ultrazohm/uz_d_absolute_encoder/Project Outputs for uz_d_absolute_encoder/Rev02/BOM/BOM_JLC-uz_d_absolute_encoder_24_11_25.xlsx

Quantity | Comment | Designator | Manufacturer | Value | Description | Footprint | Voltage | Dielectric | Manufacturer Part Number | LCSC Part Number
19 | 100 nF | C7A, C7B, C7C, C8A, C8B, C8C, C9A, C9B, C9C, C14A, C14B, C14C, C15A, C15B, C15C, C16A, C16B, C16C, C17 | YAGEO | 100 nF | Capacitor 0603, 50 VDC, 100 nF, X7R | C_0603 |  |  | CC0603KRX7R9BB104 | C14663
12 | 1 nF | C10A, C10B, C10C, C11A, C11B, C11C, C12A, C12B, C12C, C13A, C13B, C13C | AVX | 1 nF | Capacitor 0603, 50 VDC, 1 nF, C0G | C_0603 |  |  | 06035A102JAT2A | C106246
1 | 150060BS75000 | D1 | Wuerth Elektronik |  | WL-SMCW SMD Mono-color Chip LED Waterclear Blue | WL-SMCW_0603 |  |  | 150060BS84000 | C5197644
1 | KT-0603R | D2 | Hubei KENTO Elec |  | LED RED 520~625NM 90~100MCD@20MA TOP VIEW 0603 ROHS | WL-SMCW_0603 |  |  | KT-0603R | C2286
1 | 19-217/GHC-YR1S2/3T | D3 | Everlight Elec |  | LED GREEN 520~535NM 112~258MCD@20MA TOP VIEW 0603 ROHS | WL-SMCW_0603 |  |  | 19-217/GHC-YR1S2/3T | C72043
6 | CDSOT23-SM712 | D4A, D4B, D4C, D5A, D5B, D5C | Bourns | 7V | TVS Diode 7V | SOT95P230X117-3N | 7V |  | CDSOT23-SM712 | C404012
3 | Littelfuse_PTC_1812 | F1, F2, F3 | Littelfuse | PTC, 1.1 A, 24V | POLYSWITCH RESETTABLE DEVICES | 1812_PTC_Polyfuse_Littelfuse | 24V |  | Littelfuse_PTC_1812 | C70119
3 | DSUB1.385-2H9 | J1A, J1B, J1C | TE Connectivity |  | Connector; D Subminiature; 9 Position; Right Angle; Pitch 1.385 mm | DSUB1.385-2H9 |  |  | DSUB1.385-2H9 | C141882
9 | BLM31PG330SN1L | L1A, L1B, L1C, L2A, L2B, L2C, L3A, L3B, L3C | Murata Electronics | 33ohms | 9mΩ ±25% 33Ω@100MHz 6A | IND 1206_3216 |  |  | BLM31PG330SN1L | C74090
27 | 0R | R2, R10A, R10B, R10C, R11A, R11B, R11C, R12A, R12B, R12C, R13A, R13B, R13C, R14A, R14B, R14C, R17A, R17B, R17C, R26A, R26B, R26C, R27A, R27B, R27C, R40, R41 | YAGEO | 0R | SMD resistor E24 series | RES 0603_1608 |  |  | RC0603JR-070RL | C21189
1 | 24k9 | R8 | Vishay | 24k9 | SMD resistor 1% | RES 0603_1608 |  |  | CRCW060324K9FKEA | C844763
12 | 10k | R15A, R15B, R15C, R16A, R16B, R16C, R23A, R23B, R23C, R24A, R24B, R24C | KOA Speer | 10k | SMD resistor E24 series | RES 0603_1608 |  |  | RK73B1JTTD103J | C25804
12 | 1k | R18A, R18B, R18C, R19A, R19B, R19C, R20A, R20B, R20C, R21A, R21B, R21C | UNI-ROYAL | 1k | SMD resistor E24 series | RES 0603_1608 |  |  | 0603WAF1001T5E | C21190
6 | 120R | R22A, R22B, R22C, R25A, R25B, R25C | KOA Speer | 120R | SMD resistor E24 series | RES 0603_1608 |  |  | RK73B1JTTD121J | C22787
4 | 4k7 | R29, R31, R32, R33 | UNI-ROYAL | 4k7 | SMD resistor E24 series | RES 0603_1608 |  |  | 0603WAF4701T5E | C23162
1 | 2k2 | R30 | KOA Speer | 2k2 | SMD resistor E24 series | RES 0603_1608 |  |  | RK73B1JTTD222J | C4190
14 | 100k | R34, R35, R42A, R42B, R42C, R43A, R43B, R43C, R44A, R44B, R44C, R45A, R45B, R45C | KOA Speer | 100k | SMD resistor E24 series | RES 0603_1608 |  |  | RK73B1JTTD104J | C25803
12 | 10R | R36A, R36B, R36C, R37A, R37B, R37C, R38A, R38B, R38C, R39A, R39B, R39C | Vishay | 10R | SMD 1/10watt 10ohms 1% | RES 0603_1608 |  |  | CRCW060310R0FKTA | C2091419
3 | SS-3235S-L1 | S1A, S1B, S1C | XKB Connection | DPDT | 50mA Horizontal attachment DPDT 12V 12V 50mA 10,000 times Black SMD Slide Switches ROHS | SS-3235S-L1 |  |  | SS-3235S-L1 | C500055
1 | M24C02-WMN6TP | U1 | STMicroelectronics | M24C02-WMN6TP | 2Kbit I2C SOP-8 EEPROM ROHS | D0008A_N |  |  | M24C02-WMN6TP | C7562
3 | TXB0108PWR | U2A, U2B, U2C | Texas Instruments | 3.6 - 5.5V | Voltage Levels 8-Bit Bi-directional V-Level Translator | SOP65P640X120-20N |  |  | TXB0108PWR | C53406
6 | THVD1450DR | U3A, U3B, U3C, U4A, U4B, U4C | Texas Instruments |  | 3.3-V to 5-V RS-485 transceiver with +/-18-kV IEC ESD protection 8-SOIC -40 to 125 | SOIC127P600X175-8N |  |  | THVD1450DR | C2671361
