ultrazohm/uz_d_absolute_encoder/Project Outputs for uz_d_absolute_encoder/Rev01/SCH_uz_d_absolute_encoder_Default_Rev01.PDF

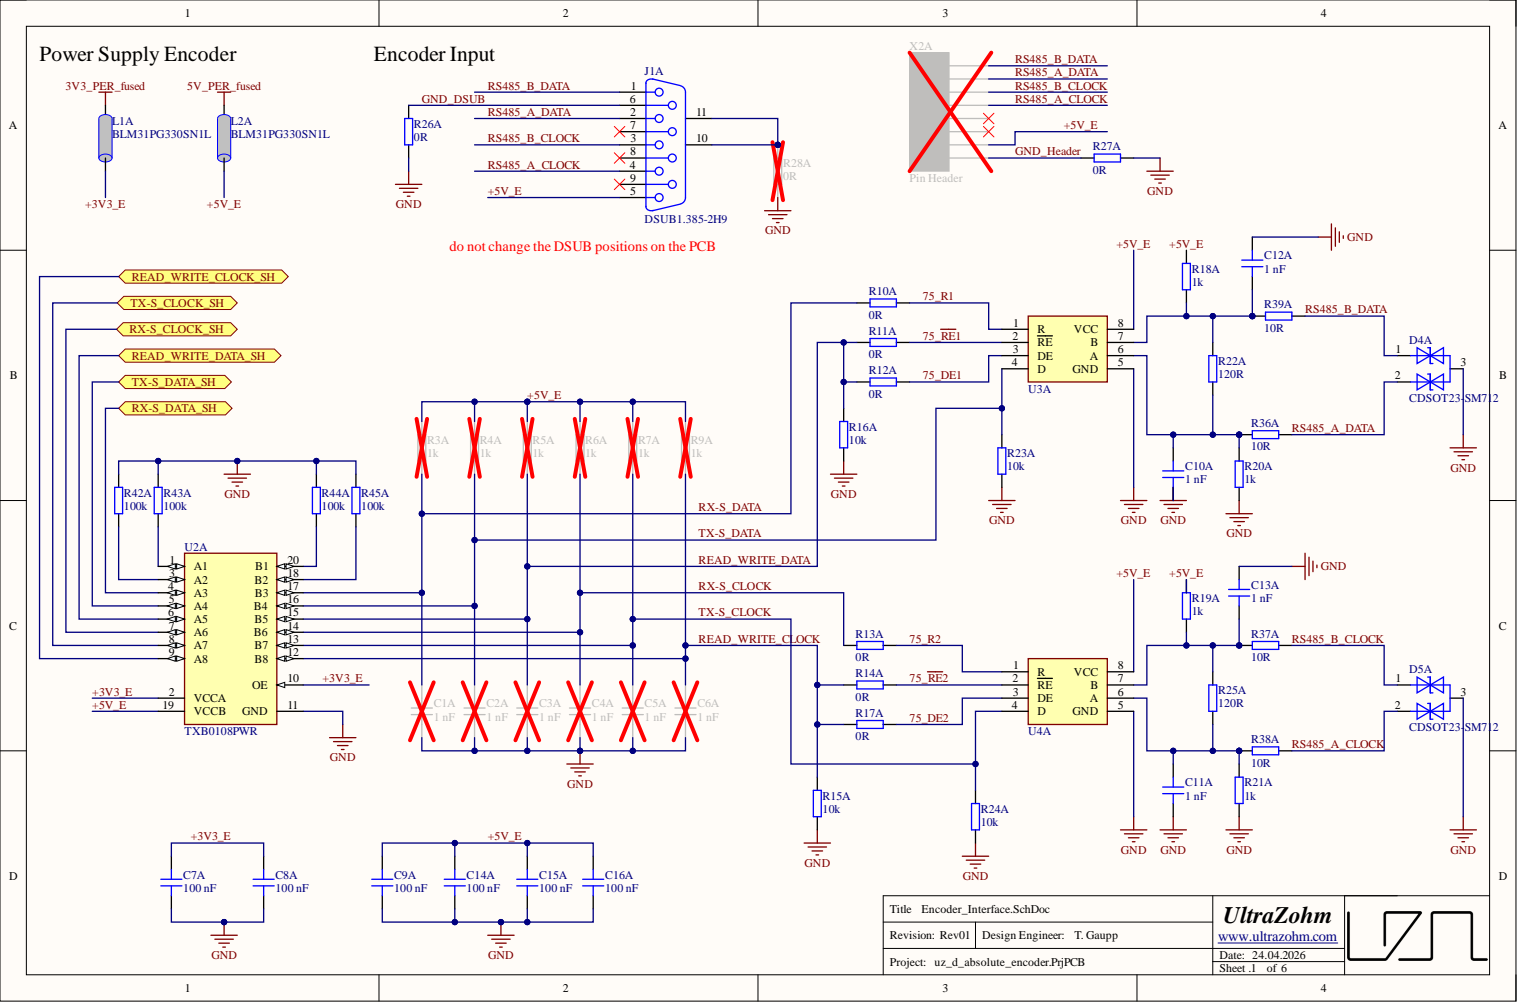
[picture p11: page 1]

do not change the DSUB positions on the PCB

DE 3
D 4

Revision:

Date: 24.04.2026

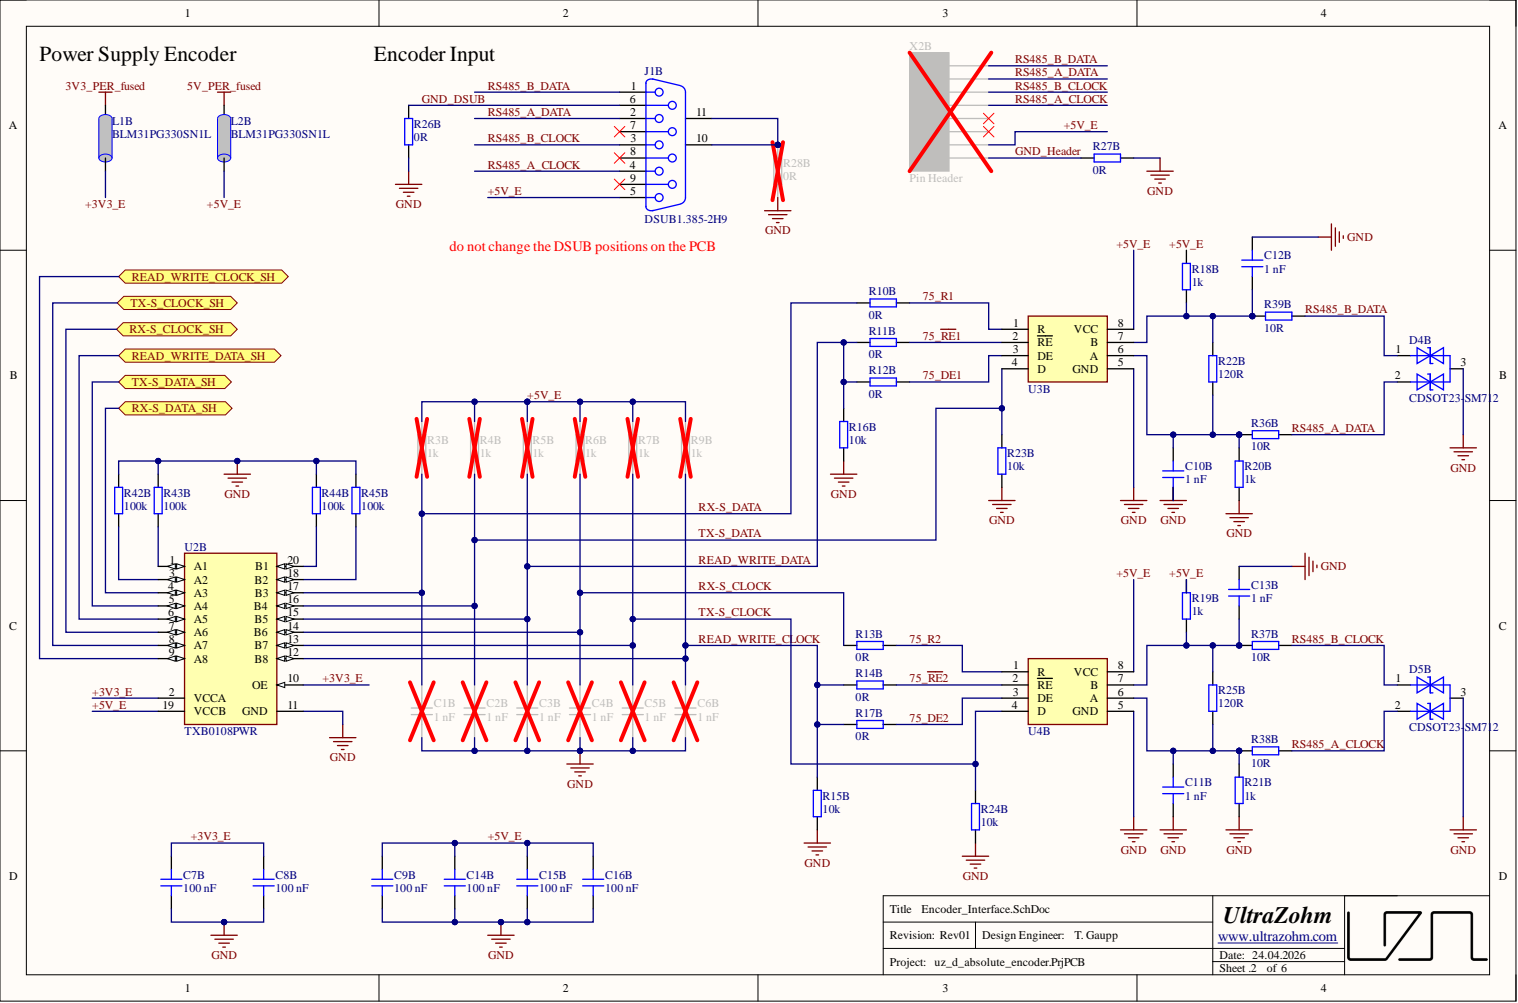
[picture p12: page 2]

do not change the DSUB positions on the PCB

DE 3
D 4

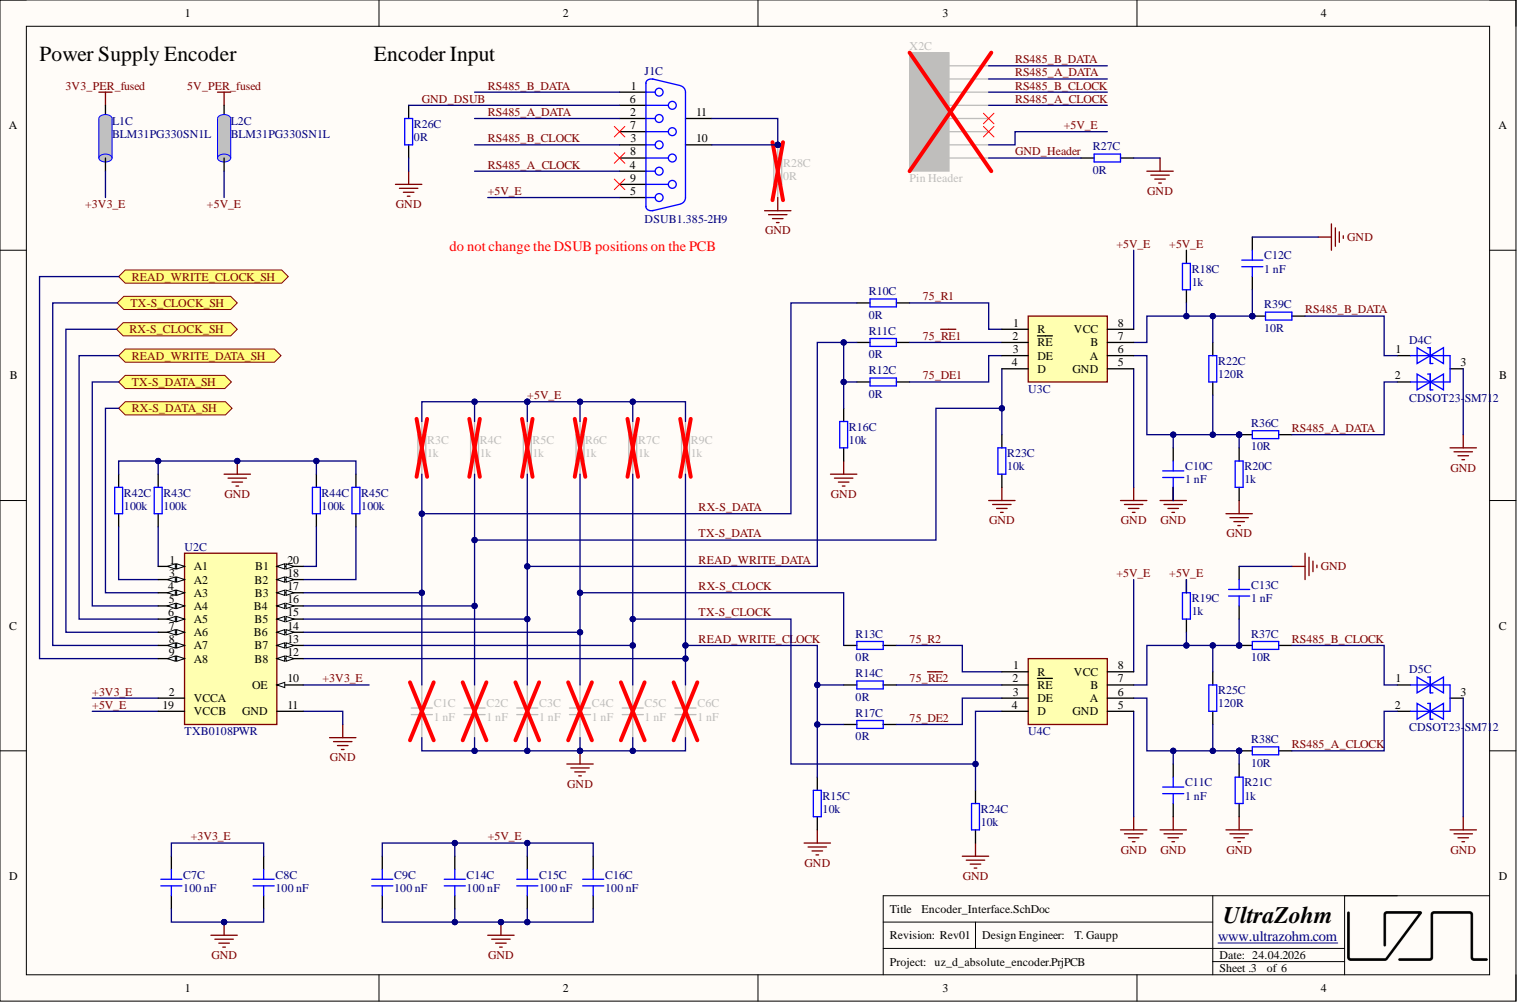
[picture p13: page 3]

do not change the DSUB positions on the PCB

DE 3
D 4

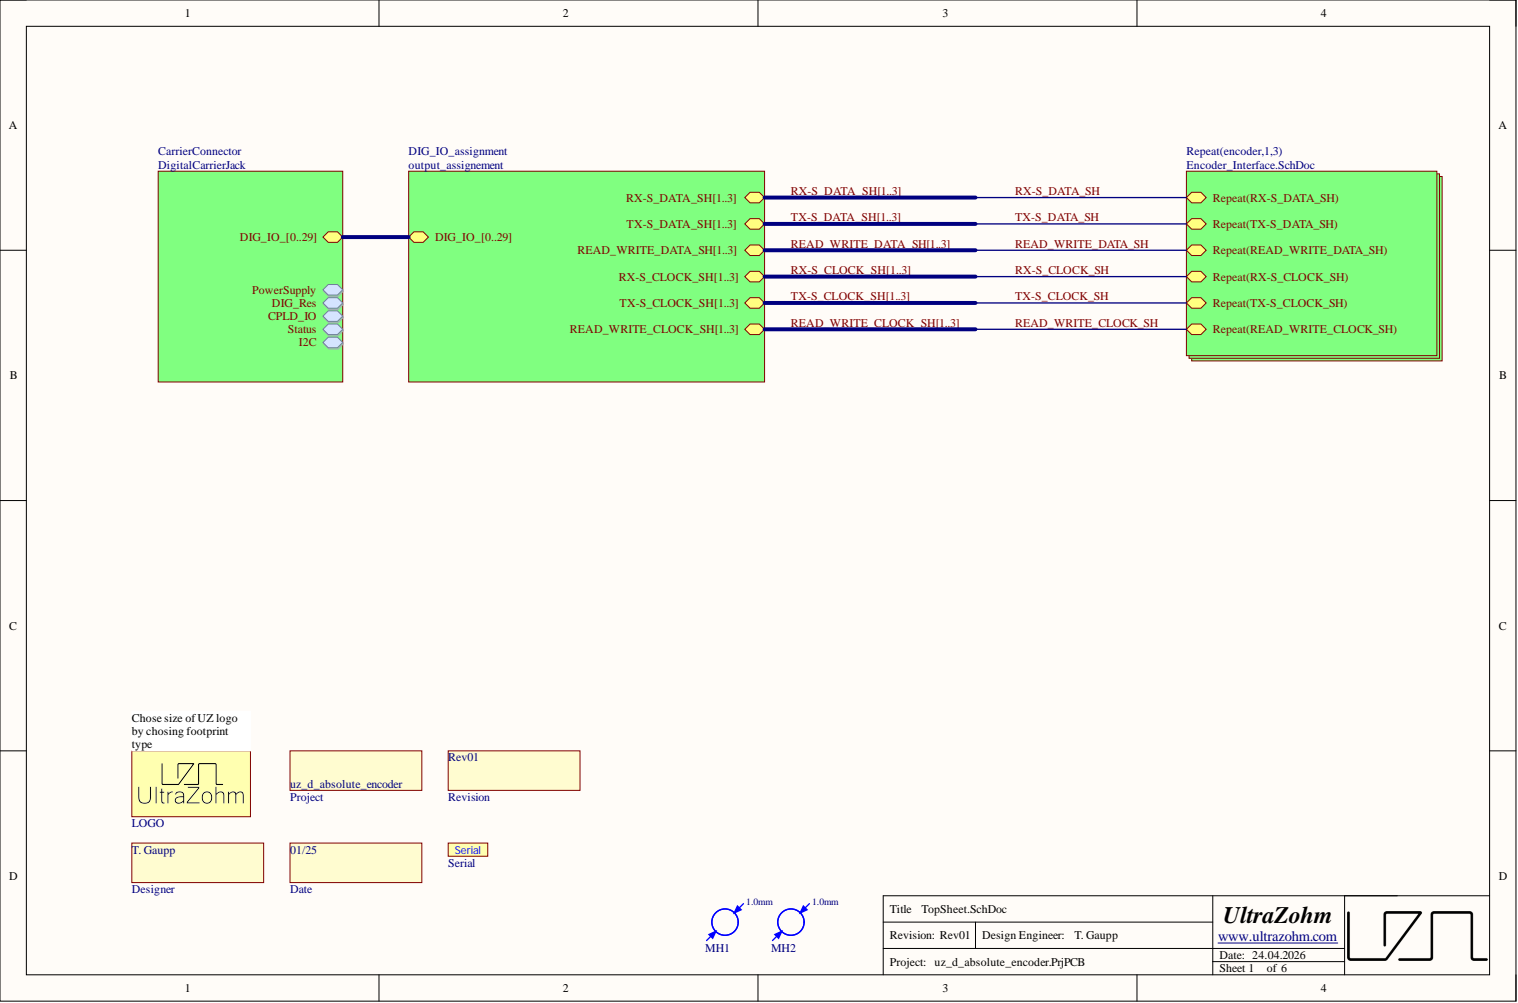
[picture p14: page 4]

Chose size of UZ logo
by chosing footprint
type

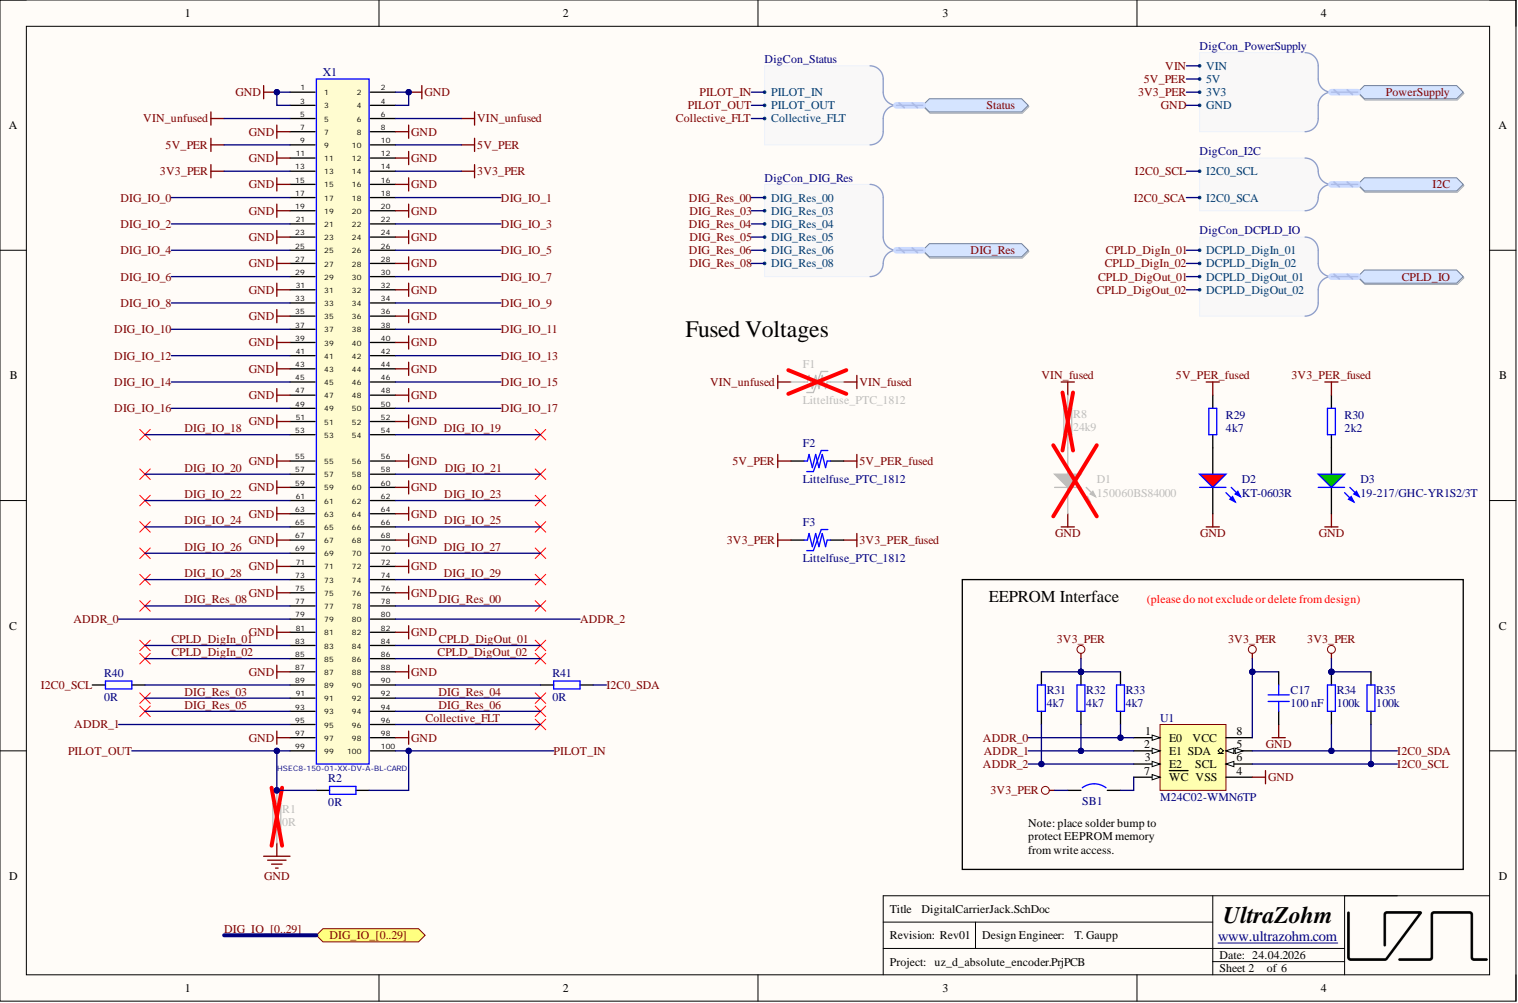
[picture p15: page 5]

HSEC8-150-01-XX-DV-A-BL-CARD

Note: place solder bump to
protect EEPROM memory
from write access.

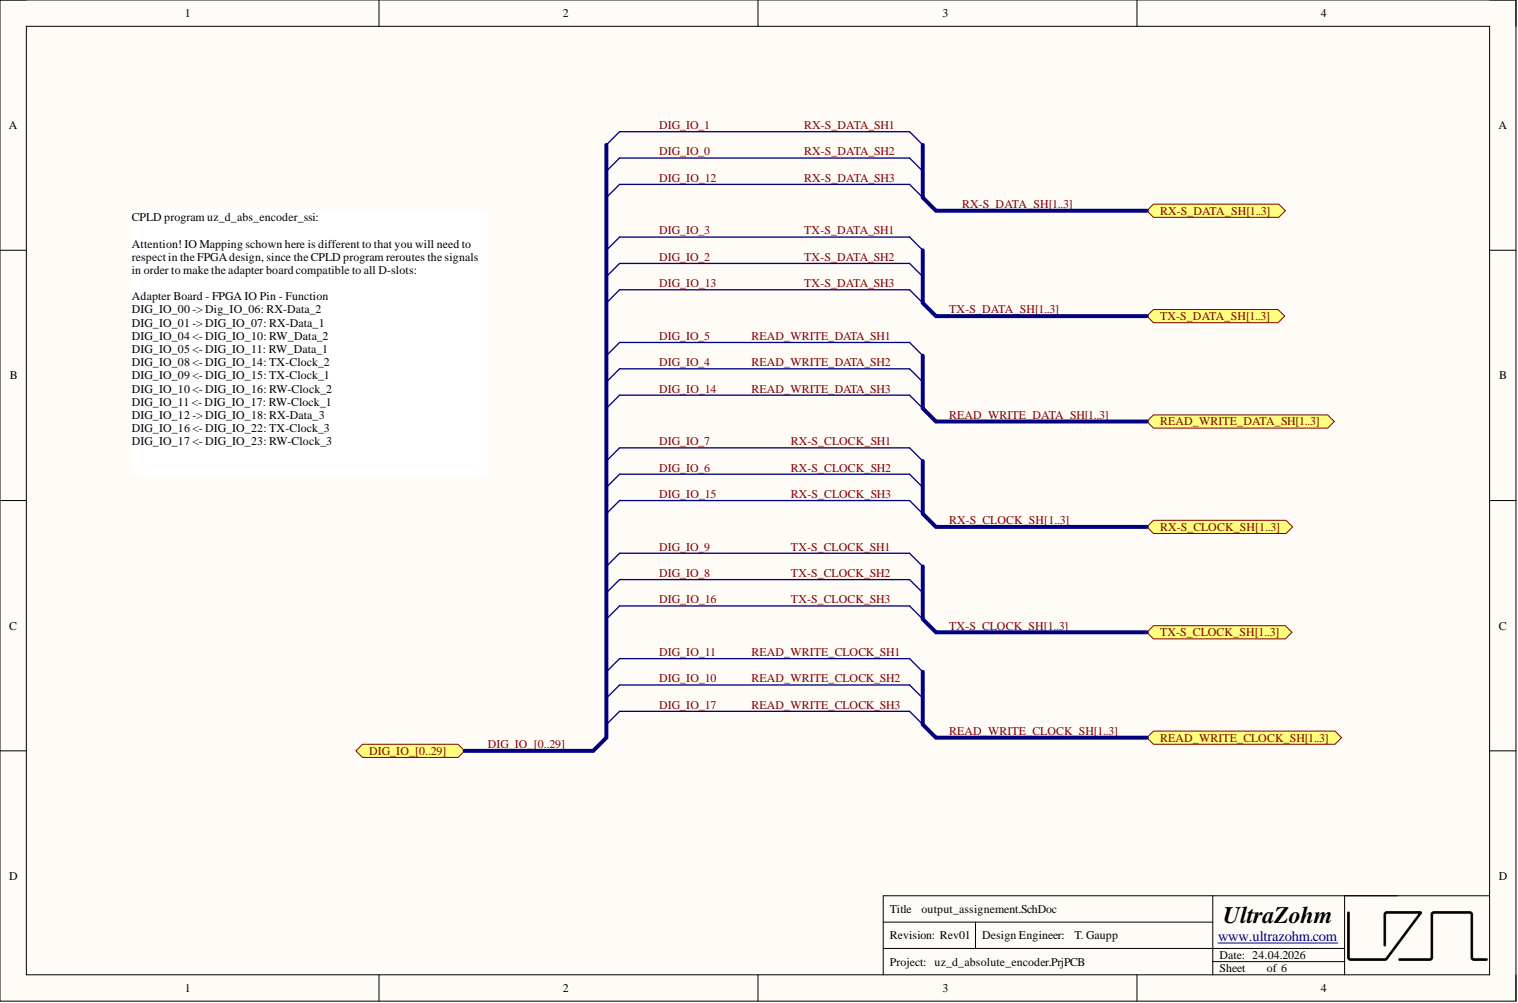
[picture p16: page 6]

Attention! IO Mapping schown here is different to that you will need to
respect in the FPGA design, since the CPLD program reroutes the signals
in order to make the adapter board compatible to all D-slots:
