ultrazohm/uz_d_absolute_encoder/(list of files, drawings)

Other design files:
DigitalCarrierJack.SchDoc
Encoder_Interface.SchDoc
output_assignement.SchDoc
TopSheet.SchDoc
UltraZohm_Digital_Template.PrjPCB
uz_d_absolute_encoder.PrjPCB
UZ_D_ENDAT.PcbDoc
UZ_D_Template.PrjPCB
