ultrazohm/uz_d_absolute_encoder/(commit log)

2020-02-18 first commit empty template exists
    [DigitalCarrierJack.SchDoc, TopSheet.SchDoc, UltraZohm_Digital_Template.PcbDoc, UltraZohm_Digital_Template.PrjPCB]
2022-02-07 update to match new carrierboard Rev04
    [DigitalCarrierJack.SchDoc, TopSheet.SchDoc, UZ_D_Template.PcbDoc, UZ_D_Template.PrjPCB, UltraZohm_Digital_Template.PcbDoc]
2022-12-22 Upper and lower component keep out rooms inserted to avoid collision with rails
    [UZ_D_Template.PcbDoc, UZ_D_Template.PrjPCB]
2022-12-23 configure suitable PCB grid and snap points
    [UZ_D_Template.PcbDoc]
2023-01-30 - sheet numbering - add UZ logo - fix pcb outline on M1, and lock the outline - add annotation symbols on pcb
    [DigitalCarrierJack.SchDoc, TopSheet.SchDoc, UZ_D_Template.PcbDoc, UZ_D_Template.PrjPCB]
2023-01-30 - add pcb rules from jlc - add variant
    [DigitalCarrierJack.SchDoc, UZ_D_Template.PcbDoc, UZ_D_Template.PrjPCB]
2023-12-25 add EEPROM
    [DigitalCarrierJack.SchDoc, TopSheet.SchDoc, UZ_D_Template.PcbDoc, UZ_D_Template.PrjPCB]
2023-12-25 mark EEPROM write protect pull-up / pull-down as DNP
    [UZ_D_Template.PrjPCB]
2024-01-09 add solder bumper instead of pull-up at EEPROM write access protection pin
    [DigitalCarrierJack.SchDoc, UZ_D_Template.PcbDoc]
2024-01-30 optimize snap options for easier layouting
    [DigitalCarrierJack.SchDoc, UZ_D_Template.PcbDoc]
2024-10-24 - Outline closed, radius adjusted to 3 mm and set to integer coordinates - added 1mm Mounting Holes to TopSheet - added Mounting holes near the gold fingers with coordinates from UZ_A_LTC2311
    [TopSheet.SchDoc, UZ_D_Template.PcbDoc]
2024-10-24 - safed project
    [UZ_D_Template.PrjPCB]
2024-10-28 - Altium Projektdateien umbenannt - Encoder Interface (DSubs) hinzugefügt
    [Encoder_Interface.SchDoc, TopSheet.SchDoc, UZ_D_ENDAT.PcbDoc, UZ_D_ENDAT.PrjPCB]
2024-10-30 uz_d_endat altium Projekt angelegt, aufbau TopSheet festgelegt (orientiert an UZ_D_Resolver Projekt), output assignment zur zuweisung der drei encoder Schnittstellen zu die DIG_IO-Ausgängen
    [DigitalCarrierJack.SchDoc, EDI2CAP.CFG, Encoder_Interface.SchDoc, SOIC127P600X175-8N.PcbLib, THVD1450D.SchLib, THVD1450D.stp, TopSheet.SchDoc, UZ_D_ENDAT.PrjPCB]
2024-11-05 - added all compnents to the schematics - finished the overall layout of the schematics
    [Componentes_SOC.SchLib, DigitalCarrierJack.SchDoc, Encoder_Interface.SchDoc, TopSheet.SchDoc, UZ_D_ENDAT.PrjPCB, output_assignement.SchDoc]
2024-11-05 corrected and added missing footprints
    [Componentes_SOC.SchLib, DigitalCarrierJack.SchDoc, Encoder_Interface.SchDoc, TopSheet.SchDoc, UZ_D_ENDAT.PcbDoc, UZ_D_ENDAT.PrjPCB]
2024-11-05 updatet DSub footprint updated pcb document
    [Encoder_Interface.SchDoc, UZ_D_ENDAT.PcbDoc, UZ_D_ENDAT.PrjPCB, output_assignement.SchDoc]
2024-11-06 started PCB layout
    [DigitalCarrierJack.SchDoc, Encoder_Interface.SchDoc, UZ_D_ENDAT.PcbDoc]
2024-11-08 finished PCB Layout, ready for review
    [DigitalCarrierJack.SchDoc, Encoder_Interface.SchDoc, UZ_D_ENDAT.PcbDoc, UZ_D_ENDAT.PrjPCB, output_assignement.SchDoc]
2024-11-13 - made corrections on the schematics and the PCB Layout - added polygon layers on the top, GND and bottom layer - added EEPROM Interface - added a TVS diodes (D4 & D5) and 100R resistor for transient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
    [DigitalCarrierJack.SchDoc, Encoder_Interface.SchDoc, TopSheet.SchDoc, UZ_D_ENDAT.PrjPCB]
2024-11-15 - errors corrected and improvements implemented - added ferrite bread to the DBlib - added transceiver to DBlib
    correct model of the THVD1450D Tranceiver still missing!!
    [Componentes_SOC.SchLib, EDI2CAP.CFG, Encoder_Interface.SchDoc, SOIC127P600X175-8N.PcbLib, THVD1450D.SchLib, THVD1450D.stp, chips.prt, soic127p600x175-8n.psm]
2024-11-15 added the correct model of the THVD1450D Tranceiver
    [Encoder_Interface.SchDoc]
2024-12-05 connected the unused I/O Pins of the TXB0108 to GND via 100k resistors, wavied unimportand rule violations in the DRC
    [Encoder_Interface.SchDoc]
2024-12-13 board outline corrected
2024-12-13 level translator exchanged, now from altium lib
    [Encoder_Interface.SchDoc]
2024-12-13 R28 resistor(s) wich connects the Encoder cable to PCB-GND via the DSub housing are set to DNP
    [Encoder_Interface.SchDoc, UZ_D_ENDAT.PrjPCB]
2025-01-02 R36 - R38 changed to 10R resistor set X2 to DNP added min 1 via per GND Pin
    [DigitalCarrierJack.SchDoc, Encoder_Interface.SchDoc, UZ_D_ENDAT.PrjPCB]
2025-01-03 C7,C8,C9,C14,C15,C16,C17 --> C14663 D4,D5 --> C404012 L1,L2 --> C74090 R3,R4,R5,R6,R7,R9 R18,R19,R20,R21 --> C21190 U2: added LCSC Nr --> C53406 U3,U4 changed from THVD1450D to THVD1450DR --> C2671361
    [DigitalCarrierJack.SchDoc, Encoder_Interface.SchDoc, TopSheet.SchDoc, UZ_D_ENDAT.PrjPCB]
2025-01-07 reduce polygons at gold finger edge to resolve collision with chamfer
    [TopSheet.SchDoc, UZ_D_ENDAT.PrjPCB]
2025-01-07 add production files for Rev01
    [BOM_JLC-UZ_D_ENDAT(Default)_mod_05Jan2025.xlsx, Pick Place for UZ_D_ENDAT(Default).csv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]
2025-04-26 renamed repo from uz_d_endat to uz_d_absolute_encoder and worked in #issue:1
    [BOM_JLC-uz_d_absolute_encoder(Default).xlsx, Encoder_Interface.SchDoc, Pick Place for uz_d_absolute_encoder(Default).csv, TopSheet.SchDoc, UZ_D_ENDAT.PrjPCB, output_assignement.SchDoc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]
2025-04-26 added ZC part number on pcb and added new output files (01), that is the only difference to Rev01 outputs
    [BOM_JLC-uz_d_absolute_encoder(Default).xlsx, Encoder_Interface.SchDoc, Pick Place for uz_d_absolute_encoder(Default).csv, TopSheet.SchDoc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]
2025-05-08 Commit for Rev02: - added sliding switch for selecting supply voltage of encoder 5V or 24V per channel - adapted outputjob for new project parameters - created production files
    [BOM_JLC-uz_d_absolute_encoder(Default).xlsx, DigitalCarrierJack.SchDoc, Encoder_Interface.SchDoc, Pick Place for uz_d_absolute_encoder(Default).csv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]
2025-11-24 add missing outputs (nc drill) to zip
    [BOM_JLC-uz_d_absolute_encoder(Default).xlsx, BOM_JLC-uz_d_absolute_encoder_24_11_25.xlsx]
2026-04-24 only reworked pinout comment in output_assignement.SchDoc to align it with CPLD program name and add pins that have not been mentioned yet. also created Rev01 schematic for having it in the output fi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
    [output_assignement.SchDoc]
